kubaodias/armboard/spis_tresci.tex

\documentclass[a4paper]{article}
\usepackage[polish]{babel}
\usepackage[utf8]{inputenc}
\usepackage[OT4]{fontenc}
\usepackage{tabularx}

\setlength{\textwidth}{15cm}
\setlength{\evensidemargin}{0cm}
\setlength{\oddsidemargin}{0cm}
\setlength{\headheight}{0.0in}
\setlength{\headsep}{0.0in}
\setlength{\marginparwidth}{0cm}
\setlength{\hoffset}{0cm}
\setlength{\voffset}{0cm}
\setlength{\extrarowheight}{3pt}

\linespread{1.3}

\pagestyle{empty}

\begin{document}
	\tableofcontents
	
	\newpage
	\section{Wprowadzenie}
		\subsection{Wbudowany Linux}
		\subsection{Platforma sprzętowa}
		\subsection{Cel pracy}
		\subsection{Przykładowe implementacje}

	\section{Część sprzętowa}
		\subsection{Mikroprocesor}
			\subsubsection{Wymagania}
			\subsubsection{Porównanie dostępnych układów}
		\subsection{Nośniki pamięci}
			\subsubsection{Pamięć SDRAM}			
			\subsubsection{Pamięć NAND i NOR Flash}
			\subsubsection{Pamięć Serial Dataflash}
			\subsubsection{Karty pamięci}
		\subsection{Ethernet}
		\subsection{USB}
			\subsubsection{Host USB}
			\subsubsection{Urządzenie USB}
		\subsection{Wyświetlacz LCD}
			\subsubsection{Kontroler wyświetlacza}
		\subsection{Urządzenia peryferyjne mikrokontrolera}
		\subsection{Pozostałe układy}
			\subsubsection{Programator}
			\subsubsection{Przetwornik Audio}
			\subsubsection{Moduł Bluetooth}
			\subsubsection{Inne możliwości}
		\subsection{Gotowy układ}
			\subsubsection{Wykonanie płytki drukowanej}
			\subsubsection{Lutowanie}
			\subsubsection{Problemy}

	\section{Część programowa}
		\subsection{Programowanie układu}
			\subsubsection{OpenOCD}
			\subsubsection{Kompilator}
			\subsubsection{GDB}
			\subsubsection{Eclipse}
		\subsection{Bootloader}
			\subsubsection{Bootloader inicjalizujący}
			\subsubsection{Bootloader główny}
		\subsection{Jądro Linuksa}
			\subsubsection{Kompilacja}
			\subsubsection{Wybór modułów}
		\subsection{initrd}
		\subsection{Dystrybucja Linuksa}
		\subsection{System plików}
		\subsection{Moduły}
			\subsubsection{Ethernet}
			\subsubsection{Kontroler LCD}
		\subsection{Aplikacja demonstracyjna}
		
	\section{Podsumowanie}
	\section{Literatura}
\end{document}
