kubaodias/armboard/(commit log)

2009-03-13 Initial import of Eagle schematic files
    [arm_board.sch]
2009-03-14 MCU schematic is done
    [arm_board.sch]
2009-03-14 Added library and schematic for K4S561632J SDRAM memory
    [arm_board.sch]
2009-03-14 SDRAM is connected
    [arm_board.sch]
2009-03-14 Added library symbols for AT45DB021D and AT93C66 external memories. Connected them to microcontroller.
    [arm_board.sch]
2009-03-14 Added library directory with STE100P and SD/MMC card connector libs
    [arm_board.sch]
2009-03-14 Changed libraries directory. Added SD/MMC connector to schematic
    [arm_board.sch]
2009-03-14 SD/MMC cards are connected. All external memories are connected. Corrected bug in SDRAM memory voltage supply.
    [arm_board.sch]
2009-03-14 Initial connection of STE100P
    [arm_board.sch]
2009-03-15 Connected some pins of STE100P and RJ-45 socket
    [arm_board.sch]
2009-03-15 Digital and analog ground nets are distinguished
    [arm_board.sch]
2009-03-15 Before moving directories
    [arm_board.sch]
2009-03-16 Added library and schematic for SSD1906 LCD controller
    [arm_board.sch]
2009-03-16 Connected pins of SSD1906 to MCU
    [arm_board.sch]
2009-03-18 Added library for BTM222 Bluetooth module
    [arm_board.sch]
2009-03-18 Corrected minor bugs in LCD controller schematic
    [arm_board.sch]
2009-03-21 Added LM3940 5V to 3.3V LDO voltage regulator
    [arm_board.sch]
2009-03-21 Added voltage supply, DBGU, UART and USB
    [arm_board.sch]
2009-03-22 Added TLV320DAC23 Audio DAC
    [arm_board.sch]
2009-03-22 Correct Ethernet RCL elements
    [arm_board.sch]
2009-03-23 Added elements to Audio DAC
    [arm_board.sch]
2009-03-23 Connected PCK to LCD controller and Audio DAC
    [arm_board.sch]
2009-03-24 Added JTAG interface
    [arm_board.sch]
2009-03-24 Finished Ethernet schematic
    [arm_board.sch]
2009-03-25 Added fuses, diodes and capacitors to voltage supply circuit
    [arm_board.sch]
2009-03-25 Added main and extension board schematics
    [ext_board.sch, main_board.sch]
2009-03-25 Corrected main board schematic - mostly element numbers, but also bugs in Serial Dataflash and EEPROM voltage supply and LCD interface (NBS1/NUB pin)
    [main_board.sch]
2009-03-25 Moved voltage supply and LEDs to main schematic, corrected some minor bugs
    [main_board.sch]
2009-03-26 Added connectors to external board
    [main_board.brd, main_board.sch]
2009-03-28 Created board dimension layer, placed Ethernet and voltage supply components
    [main_board.brd, main_board.sch]
2009-03-28 Connected Ethernet, USB, SD/MMC, SDRAM (chips on both sides of PCB) and voltage supply
    [main_board.brd, main_board.sch]
2009-03-29 All components placed on the board
    [main_board.brd, main_board.sch]
2009-03-29 DRC set
    [main_board.brd]
2009-03-29 Connected pins located near each other
    [main_board.brd]
2009-03-29 Conected lower bytes to SDRAM memories
    [main_board.brd]
2009-03-29 Started connecting address lines of SDRAM
    [main_board.brd]
2009-03-29 Connected D8-D15 to SDRAM memory
    [main_board.brd]
2009-03-29 Connected RCL components near crystal and PLL loop
    [main_board.brd]
2009-03-30 Connected SDCK, SDCKE and created bus for D8-D15
    [main_board.brd]
2009-03-30 Connected supply voltages near microcontroller
    [main_board.brd]
2009-03-30 Connected all components of USB (except HDMA and HDPA lines) and more components of Ethernet
    [main_board.brd]
2009-03-31 Starting to connect address lines to both memories
    [main_board.brd]
2009-03-31 !!! Changed location of SDRAM !!!
    [main_board.brd]
2009-03-31 Connected elements near PLL and crystals
    [main_board.brd]
2009-03-31 Placed all capacitors for +1V8
    [main_board.brd]
2009-03-31 Connected D16-D23 to SDRAM
    [main_board.brd]
2009-03-31 Connected data lines to one SDRAM chip
    [main_board.brd]
2009-03-31 Connected A6-A11 to one of the memories
    [main_board.brd]
2009-03-31 Connected elements to north side of ARM, A6-A15 address lines are going out of the microcontroller
    [main_board.brd, main_board.sch]
2009-03-31 Connected voltage regulators
    [main_board.brd]
2009-03-31 Corrected connection of voltage regulators
    [main_board.brd]
2009-03-31 Connected D8-D15 to the SDRAM chip
    [main_board.brd]
2009-04-03 Connected all capacitors to memories and some to the microcontroller
    [main_board.brd]
2009-04-03 Placed all capacitors near memories and microcontroller
    [main_board.brd]
2009-04-04 Connected RAS, CAS, SDCK, SDCKE, SDWE to both memory chips
    [main_board.brd, main_board.sch]
2009-04-04 Connected A2-A11 lines to the first memory. All NBS lines are connected to both memories
    [main_board.brd, main_board.sch]
2009-04-04 Corrected placement of capacitors near memories. Connected A13 and A14 to second memory
    [main_board.brd]
2009-04-04 Address lines A13 and A14 from first memory are ready to be connected
    [main_board.brd]
2009-04-04 NOE, NWE, NWAIT and NCS3 are ready to be connected NWAIT line is now going out of the microcontroller
    [main_board.brd, main_board.sch]
2009-04-04 C20 capacitor moved closer to the MCU. All address lines are ready to be connected
    [main_board.brd]
2009-04-04 Connected all lines to both memories, address lines are connected to external connector
    [main_board.brd, main_board.sch]
2009-04-04 D6-D15 lines are ready to be connected
    [main_board.brd, main_board.sch]
2009-04-05 Longest address lines were shortened
    [main_board.brd]
2009-04-05 Connected some elements and lines to Ethernet (mostly south side)
    [main_board.brd, main_board.sch]
2009-04-05 Connected some lines of STE100P. +1V8 voltage is connected in every place where needed.
    [main_board.brd]
2009-04-05 Connected STE100P with AT91RM9200
    [main_board.brd]
2009-04-06 Connected STE100P
    [main_board.brd]
2009-04-06 MMC0 lines are ready to be connected
    [main_board.brd, main_board.sch]
2009-04-07 Connected JTAG and UART0
    [main_board.brd, main_board.sch]
2009-04-07 Connected programmator connector
    [main_board.brd, main_board.sch]
2009-04-09 Connected D6-D15 to external connector
    [main_board.brd, main_board.sch]
2009-04-09 USB host connected
    [main_board.brd, main_board.sch]
2009-04-09 MMC and lines to the northern external connector are ready to be connected. Upper drills were moved closer to the center of the board
    [main_board.brd, main_board.sch]
2009-04-09 MMC lines are led through the board.
    [main_board.brd]
2009-04-10 Connected MMC connector
    [main_board.brd, main_board.sch]
2009-04-11 Connected southern external connector, Serial Dataflash and EEPROM
    [main_board.brd, main_board.sch]
2009-04-12 Connected all lines except PB27/PCK0
    [main_board.brd, main_board.sch]
2009-04-13 Connected PC10 line to the external connector
    [main_board.brd, main_board.sch]
2009-04-14 Some minor adjustments
    [main_board.brd, main_board.sch]
2009-04-15 Placed documentation texts
    [main_board.brd, main_board.sch]
2009-04-19 Poured ground polygon on the bottom layer
    [main_board.brd, main_board.sch]
2009-04-19 Version 1.0 of Linux Arm Board
    [main_board.brd, main_board.sch]
2009-04-19 Everything checked again, corrected placement of labels
    [main_board.brd]
2009-04-21 Added electronic parts list and corrected some element values in the schematic
    [ext_board.sch, main_board.brd, main_board.sch]
2009-04-22 Added board for programmator
    [prog_board.sch]
2009-04-25 Added programmator board and updated schematic
    [prog_board.brd, prog_board.sch]
2009-04-27 Programmator PCB is ready
    [prog_board.brd]
2009-05-08 Added openocd configuration files
    [at91sam7s64_testboard.cfg, turtelizer2.cfg]
2009-05-20 Added working configuration files for AT91RM9200 LAB
    [at91rm9200_lab.cfg, turtelizer.cfg]
2009-06-15 Added directory for memory_test
    [at91rm9200_lab.cfg]
2009-06-25 Changed big capacitors and reset button in main board
    [main_board.brd, main_board.sch, prog_board.brd, prog_board.sch]
2009-06-27 Changed RJ45 connector to J0011
    [main_board.brd, main_board.sch]
2009-06-27 Minor adjustments, +5V added to external pins
    [main_board.brd, main_board.sch]
2009-06-28 Moved upper right drill to the right
    [main_board.brd]
2009-06-28 PB27/PCK0 was added to external connector. Started working on ext_board.
    [arm_board.sch, ext_board.sch, main_board.brd, main_board.sch]
2009-06-28 Data lines for LCD, corrected to generic #2
    [ext_board.sch, main_board.sch]
2009-06-30 Added TPS61040
    [ext_board.sch, main_board.sch]
2009-07-01 Added audio jack
    [ext_board.brd, ext_board.sch]
2009-07-03 PCB dimensions, elements placement, MicroSD
    [ext_board.brd, ext_board.sch]
2009-07-04 Connected some lines to SSD1906, placed capacitors and resistors.
    [ext_board.brd, ext_board.sch, main_board.brd]
2009-07-05 Connected Audio DAC
    [ext_board.brd, ext_board.sch]
2009-07-05 Placed LCD connectors and mount drills
    [ext_board.brd]
2009-07-06 Connected LCD
    [ext_board.brd]
2009-07-08 ext_board finished
    [ext_board.brd, ext_board.sch, main_board.brd]
2009-09-02 Added block schematic
2009-09-02 Added description of PCBs used in project
2009-10-04 Added extra logs for STE100P driver
2009-10-11 Removed Legacy PTY driver from kernel configuration
2009-10-20 Configuration without framebuffer driver
2009-10-21 Adjustments for Linux ARM Board
2009-11-04 Corrected files for SSD1906 framebuffer device
